vladak/radio2mqtt/README.md

# Radio (RFM69) to MQTT gateway

Receive messages in certain format over RFM69 based radio, decode them and publish as MQTT messages using Wi-Fi.
The code assumes ESP32 based Feather running CircuitPython and certain wiring of the Radio FeatherWing.

This is the receiver piece for [shield](https://github.com/vladak/shield/).

## Hardware

Here is a bill of materials:

Purpose | Name
---|---
microcontroller | [ESP32 Feather S3](https://www.adafruit.com/product/5477)
radio antenna | high power antenna 4dBi 433MHz (410~450 MHz) 20cm/90°foldable/SMA-J (ordered from eBay)
radio | [Radio FeatherWing 433 MHz](https://www.adafruit.com/product/3230) 
interconnect | [FeatherWing doubler](https://www.adafruit.com/product/2890)

Most of the stuff comes from [Adafruit](https://www.adafruit.com/).

## Physical packaging

Originally I used the ["tracking tag"](https://www.thingiverse.com/thing:2664919) enclosure that is originally designed for Feather M0 and GPS, however I needed something quick and this seems it would fit.

Then I remixed the QtPy case and created [custom enclosure](https://github.com/vladak/radio2mqtt/tree/main/Doubler%20snap%20fit%20case) (here showing a transmitter using the same case with battery and temperature/humidity sensor, the receiver does not generally have these):

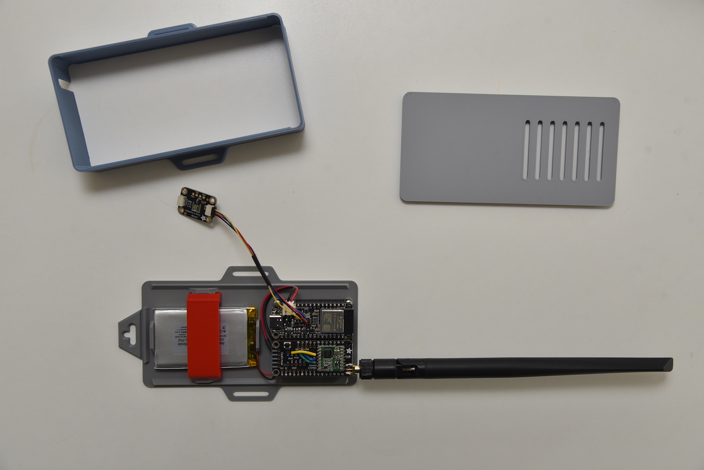
[picture p1: img/case-assembly-1.jpg]


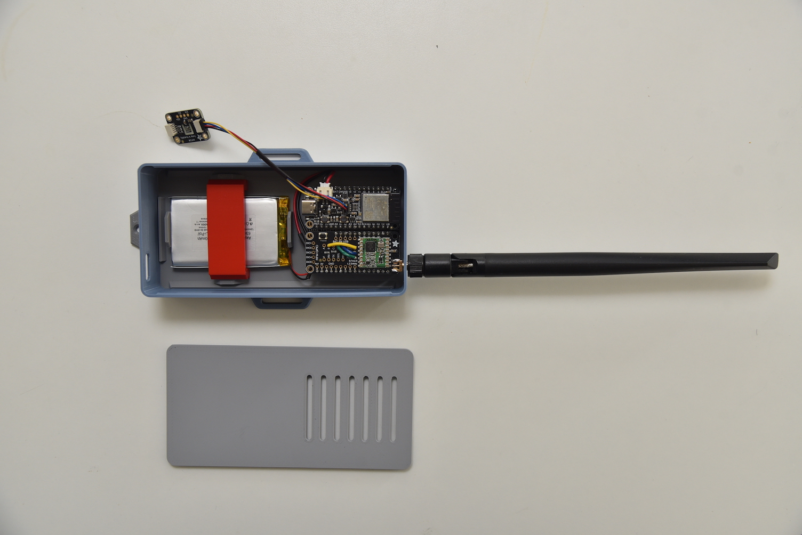
[picture p2: img/case-assembly-2.jpg]


## Software/firmware install

Firstly, the microcontroller needs to be converted to run CircuitPython 9.x (for the `circup` to work with web workflow). To do that, for ESP32 V2, I chose the [command line `esptool`](https://learn.adafruit.com/circuitpython-with-esp32-quick-start/command-line-esptool) on a Linux computer (since macOS appeared to have flaky serial connection for some reason), however these days it can be done using [Web Flasher](https://adafruit.github.io/Adafruit_WebSerial_ESPTool/) in Chrome.

If ESP32 V2 used, perform the initial set up by [creating the `settings.toml` file](https://learn.adafruit.com/circuitpython-with-esp32-quick-start/setting-up-web-workflow
) in the root directory (using `screen` when the board is connected via USB data cable) to enable web workflow:
```
f = open('settings.toml', 'w')
f.write('CIRCUITPY_WIFI_SSID = "MY_SSID"\n')
f.write('CIRCUITPY_WIFI_PASSWORD = "CHANGE_ME_WIFI_PASSWORD"\n')
f.write('CIRCUITPY_WEB_API_PASSWORD = "CHANGE_ME_WEB_API_PASSWORD"\n')
f.close()
```
and restart the microcontroller.

Then the following can be used:
- install the code
  - for ESP32S3 connected via USB, assumes Linux:
  ```
  cp *.py /media/$LOGNAME/CIRCUITPY/
  ``` 
  - for ESP32 V2, copy `*.py` files to the root directory using web workflow, assumes system with `curl` installed:
  ```
  for f in *.py; do curl -v -u :CHANGE_ME_WEB_API_PASSWORD -T "$f" -L --location-trusted "http://172.40.0.11/fs/$f"; done
  ```
- create `secrets.py` in the root directory (using the same technique as in the previous step)
- install necessary libraries from Adafruit CircuitPython bundle to the `lib` directory:
  - For Feather ESP32 V2, web based workflow has to be used:
  ```
  circup --host 172.40.0.11 --password CHANGE_ME_WEB_API_PASSWORD install -r requirements.txt
  ```
  - for ESP32-S2/ESP32-S3 and similar with USB mass storage access:
  ```
  circup install -r requirements.txt
  ```

## Configuration

There needs to be a `secrets.py` file that contains Wi-Fi credentials and MQTT configuration.
It can look like this:
```python
# This file is where you keep secret settings, passwords, and tokens!
# If you put them in the code you risk committing that info or sharing it

secrets = {
    "ssid": "foo",
    "password": "bar",
    "broker": "172.40.0.3",
    "broker_port": 1883,
    "allowed_topics": ["devices/terasa/shield"],
    "log_topic": "logs/terasa/radio2mqtt",
    "log_level": "INFO",
    "encryption_key": b"\x01\x02\x03\x04\x05\x06\x07\x08\x01\x02\x03\x04\x05\x06\x07\x08",
}
```

To transfer the file to the microcontroller, the same method as in the Install section should be used.

### Tunables

Purpose | Name                                                                                                                                              | Type | Kind
---|---------------------------------------------------------------------------------------------------------------------------------------------------|---|---
`ssid` | WiFi SSID                                                                                                                                         | `str` | Mandatory
`password` | WiFi password                                                                                                                                     | `str` | Mandatory
`broker` | MQTT broker address                                                                                                                               | `str` | Mandatory
`broker_port` | MQTT broker port                                                                                                                                  | `int` | Mandatory
`allowed_topics` | MQTT topics to publish messages to                                                                                                                 | `list` of `str` | Mandatory
`log_topic` | MQTT topic to publish log messages to                                                                                                             | `str` | Optional
`log_level` | log level, default `INFO`                                                                                                                         | `str` | Mandatory
`tx_power` | TX power to use for RFM69                                                                                                                          | `int` | Optional
`encryption_key` | 16 bytes of encryption key for RFM69                                                                                                               | `bytes` | Optional

## Lessons learned

- Using web workflow makes it easy for unattended upgrades or code changes
- The 433 MHz signal using 16.5 cm wire antenna can easily reach across the apartment, i.e. through brick/concrete walls and windows.
  - That said, it seems that the level of the placement matters. For example, when I put the sending side on the floor, the receiver (placed on top of a tall library, some 2 meters above the floor level) was not able to receive anything however when positioned a bit higher (1 meter above floor level), the receiver picked up the signal no problem. During this experiment, both antennas (16.5 straight wire) were horizontal.

## Guide/documentation links

Adafruit has largely such a good documentation that the links are worth putting here for quick reference:
- [web workflow RESTful API](https://docs.circuitpython.org/en/latest/docs/workflows.html#file-rest-api)
- [CircuitPython RGB Status Light color coding](https://learn.adafruit.com/welcome-to-circuitpython/troubleshooting#circuitpython-rgb-status-light-2978455)
- [CircuitPython for RFM69](https://learn.adafruit.com/radio-featherwing/circuitpython-for-rfm69)
- [on RFM69 wiring to the microcontroller pins](https://forums.adafruit.com/viewtopic.php?p=886292&hilit=433#p886292)
