vladak/radio2mqtt/img/case_closed.jpg

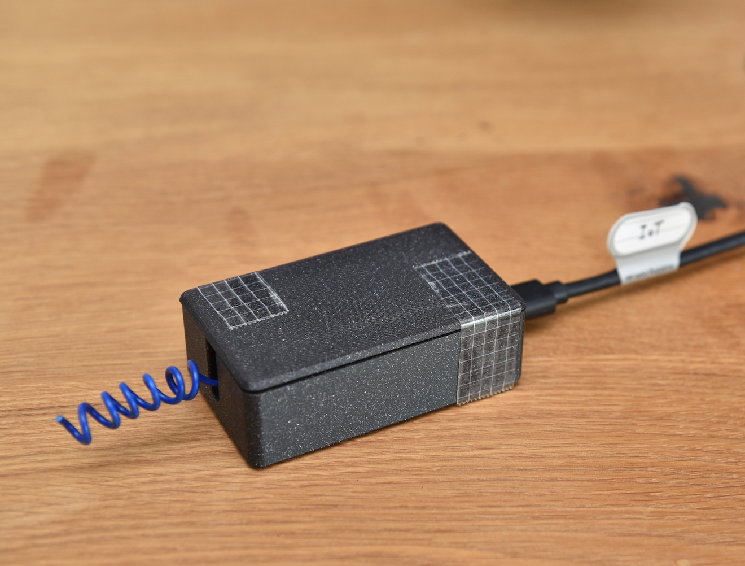
img/case_closed.jpg
