vladak/radio2mqtt/img/case_open.jpg

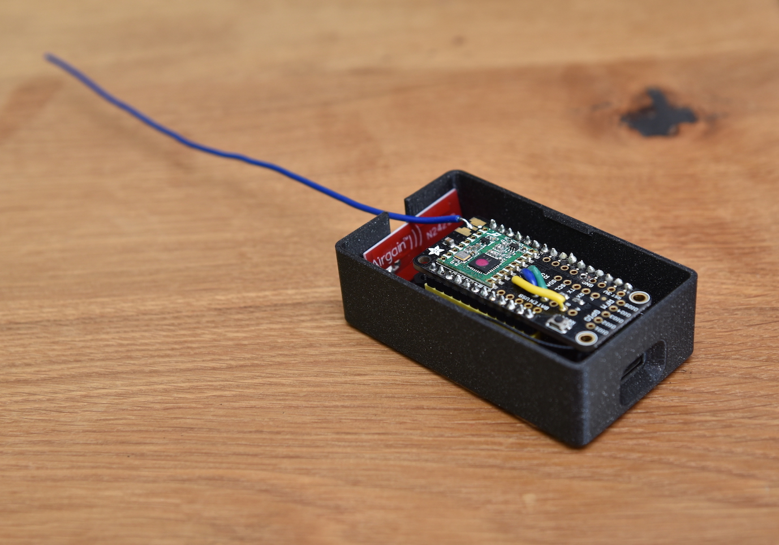
img/case_open.jpg
