vladak/radio2mqtt/Doubler snap fit case/doubler-battery_holder.stl

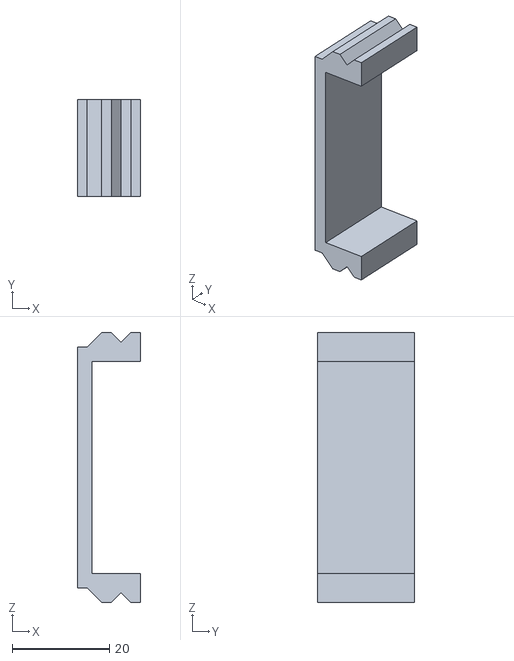
[picture p8: CAD file, 2026-03-19]
Doubler snap fit case/doubler-battery_holder.stl
13.0 x 20.0 x 55.5
