vladak/radio2mqtt/Doubler snap fit case/doubler-case.stl

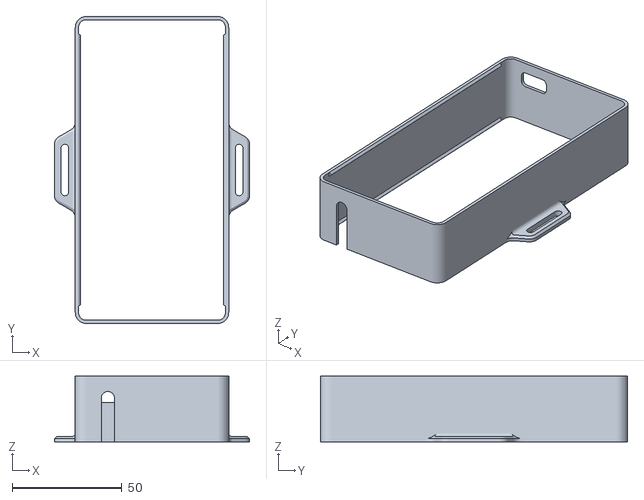
[picture p9: CAD file, 2026-03-19]
Doubler snap fit case/doubler-case.stl
89.0 x 140.0 x 30.0
