vladak/radio2mqtt/Doubler snap fit case/doubler-case-top.stl

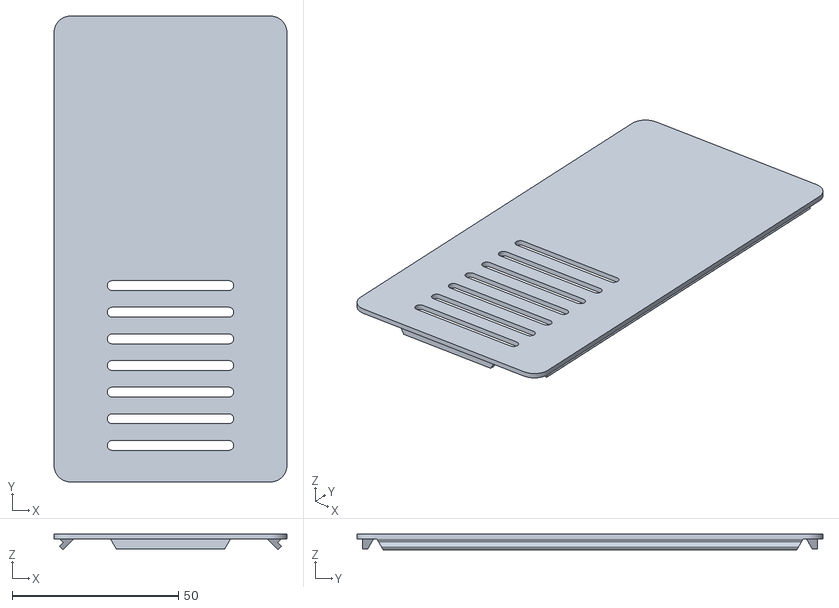
[picture p10: CAD file, 2026-03-19]
Doubler snap fit case/doubler-case-top.stl
70.0 x 140.0 x 4.70
