vladak/radio2mqtt/Doubler snap fit case/doubler-case-bottom.stl

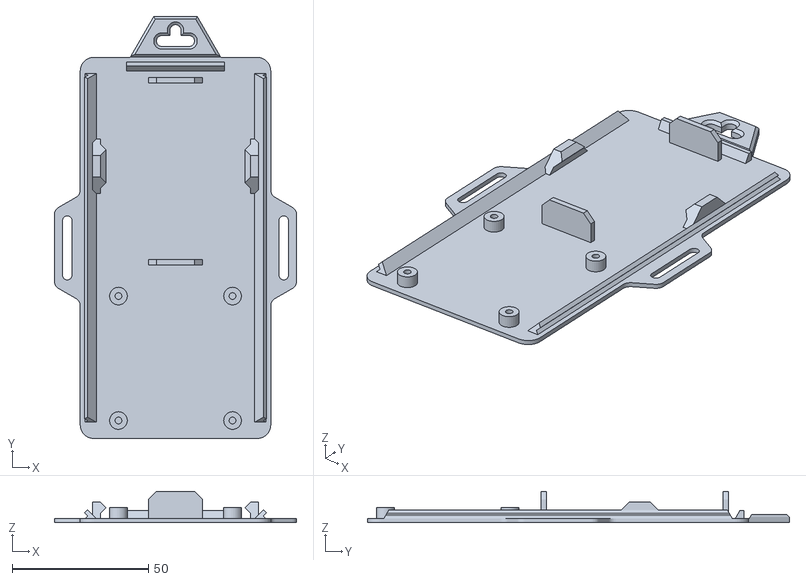
[picture p11: CAD file, 2026-03-19]
Doubler snap fit case/doubler-case-bottom.stl
89.0 x 155.0 x 11.5
