vladak/radio2mqtt/(list of files, cad)

Other CAD files:
Doubler snap fit case/Doubler snap fit case.f3d
