vladak/radio2mqtt/(threads)

Thread 5 (2024-05-17):

add photos to README.md

vladak, 2024-05-17:
Once the enclosure is 3D printed and the Neopixel fitted inside, take a picture and add it to the README.md.

vladak, 2024-05-19:
Also, label the USB cable.

Closed 2024-05-23.

Thread 8 (2024-11-01):

figure out the enclosure

vladak, 2024-11-01:
With the Feather, Ethernet wing, RFM69 wing and the doubler/tripler board, this makes it pretty unique combination. Custom enclosure would have to be designed, e.g. use https://www.youtube.com/watch?v=KwK3TnOSWus and try to remix https://learn.adafruit.com/qt-py-snap-fit-case

Thread 9 (2025-03-07):

use watchdog

vladak, 2025-03-07:
Use watchdog for better operation. I noticed a gap in the measurements that could be caused by the microcontroller being stuck for couple of hours because in the MQTT log topic it looked like this:
```
...
Client (null) received PINGRESP
Client (null) sending PINGREQ
Client (null) received PINGRESP
Client (null) sending PINGREQ
Client (null) received PINGRESP
Client (null) sending PINGREQ
Client (null) received PINGRESP
Client (null) sending PINGREQ
Client (null) received PINGRESP
Client (null) sending PINGREQ
Client (null) received PINGRESP
Client (null) sending PINGREQ
Client (null) received PINGRESP
Client (null) received PUBLISH (d0, q0, r0, m0, 'devices/logs/radio2mqtt', ... (18 bytes))
2025-03-07T07:12:04+0100 devices/logs/radio2mqtt: Temperature: 35.0C
Client (null) received PUBLISH (d0, q0, r0, m0, 'devices/logs/radio2mqtt', ... (19 bytes))
2025-03-07T07:12:04+0100 devices/logs/radio2mqtt: Frequency: 433.0mhz
Client (null) received PUBLISH (d0, q0, r0, m0, 'devices/logs/radio2mqtt', ... (21 bytes))
2025-03-07T07:12:04+0100 devices/logs/radio2mqtt: Bit rate: 250.0kbit/s
Client (null) received PUBLISH (d0, q0, r0, m0, 'devices/logs/radio2mqtt', ... (31 bytes))
2025-03-07T07:12:04+0100 devices/logs/radio2mqtt: Frequency deviation: 250000.0hz
Client (null) received PUBLISH (d0, q0, r0, m0, 'devices/logs/radio2mqtt', ... (22 bytes))
2025-03-07T07:12:04+0100 devices/logs/radio2mqtt: Waiting for packets...
Client (null) received PUBLISH (d0, q0, r0, m0, 'devices/logs/radio2mqtt', ... (133 bytes))
2025-03-07T07:12:20+0100 devices/logs/radio2mqtt: Publishing to devices/terasa/shield: {"lux": 0.0, "co2_ppm": 0, "battery_level": 93.7031, "temperature": 2.4375, "humidity": 86.9484}
```
So it looks like the device got restarted in the end for some reason.
