vladak/radio2mqtt/code.py

"""
Receive packets over radio using RFM69 and if they fit certain form,
replay their content to a MQTT topic to specified MQTT broker.

Assumes Adafruit Feather ESP32 V2 and certain wiring of 433 MHz Radio FeatherWing.
"""

import json
import math
import struct
import time
import traceback

import adafruit_logging as logging
import adafruit_rfm69
import board
import busio
import digitalio
import microcontroller
import neopixel

# pylint: disable=import-error
import socketpool

# pylint: disable=import-error
import supervisor
import wifi

# pylint: disable=no-name-in-module
from microcontroller import watchdog
from watchdog import WatchDogMode, WatchDogTimeout

from binarystate import BinaryState
from confchecks import check_bytes, check_int, check_list, check_string
from hexdump import Hexdump
from logutil import get_log_level
from mqtt import mqtt_client_setup
from mqtt_handler import MQTTHandler

try:
    from secrets import secrets
except ImportError:
    print(
        "WiFi credentials and configuration are kept in secrets.py, please add them there!"
    )
    raise


BROKER_PORT = "broker_port"
LOG_TOPIC = "log_topic"
BROKER = "broker"
PASSWORD = "password"
SSID = "ssid"
LOG_LEVEL = "log_level"
ENCRYPTION_KEY = "encryption_key"
ALLOWED_TOPICS = "allowed_topics"


class PacketDecodingError(Exception):
    """
    Exception raised when a packet cannot be decoded.
    """


def blink(pixel):
    """
    Blink the Neo pixel blue.
    """
    pixel.brightness = 0.3
    pixel.fill((0, 0, 255))
    time.sleep(0.5)
    pixel.brightness = 0


def check_tunables():
    """
    Check that tunables are present and of correct type.
    Will exit the program on error.
    """
    check_string(LOG_LEVEL)

    # Even though different transport can be selected than WiFi, the related tunables
    # are still mandatory, because at this point it is known which will be selected.
    # Also, MQTT topic is used for all transports.
    check_string(SSID)
    check_string(PASSWORD)
    check_string(BROKER)
    check_string(LOG_TOPIC, mandatory=False)
    check_int(BROKER_PORT, min_val=0, max_val=65535)

    check_list(ALLOWED_TOPICS, str)

    check_bytes(ENCRYPTION_KEY, 16, mandatory=False)


# pylint: disable=too-many-locals,too-many-statements
def main():
    """
    main loop: collect messages via radio, decode and publish to MQTT
    """

    check_tunables()

    log_level = get_log_level(secrets[LOG_LEVEL])
    logger = logging.getLogger("")
    logger.setLevel(log_level)

    # The initialization code below should not take long and the endless loop is quite tight,
    # so 5 seconds should be more than enough.
    watchdog.timeout = 5
    watchdog.mode = WatchDogMode.RAISE

    logger.info("Running")

    # Assumes certain wiring of the Radio FeatherWing.
    cs = digitalio.DigitalInOut(board.D5)
    reset = digitalio.DigitalInOut(board.D6)

    spi = busio.SPI(board.SCK, MOSI=board.MOSI, MISO=board.MISO)

    rfm69 = adafruit_rfm69.RFM69(spi, cs, reset, 433)  # Europe

    encryption_key = secrets.get(ENCRYPTION_KEY)
    if encryption_key:
        logger.debug("Setting encryption key")
        rfm69.encryption_key = encryption_key

    mqtt_client = get_mqtt_client()

    logger.debug(f"allowed topics: {secrets.get(ALLOWED_TOPICS)}")

    logger.info(f"Temperature: {rfm69.temperature}C")
    logger.info(f"Frequency: {rfm69.frequency_mhz}mhz")
    logger.info(f"Bit rate: {rfm69.bitrate / 1000}kbit/s")
    logger.info(f"Frequency deviation: {rfm69.frequency_deviation}hz")

    # The Neopixel will blink only then logging level is set to DEBUG however initialize it anyway.
    pixel = neopixel.NeoPixel(board.NEOPIXEL, 1)
    pixel.brightness = 0
    pixel_state = BinaryState()
    pixel_state.update("off")

    # Assumes tight loop below. The value is approximate. If there is high frequency of packets
    # (i.e. more frequent than this delay), the blinking will degrade into solid light.
    pixel_blink_delay = 300  # in milliseconds

    # Wait to receive packets.  Note that this library can't receive data at a fast
    # rate, in fact it can only receive and process one 60 byte packet at a time.
    # This means you should only use this for low bandwidth scenarios, like sending
    # and receiving a single message at a time.
    logger.info("Waiting for packets...")
    while True:
        watchdog.feed()

        mqtt_client.loop(0.1)

        packet = rfm69.receive(timeout=0.1)
        if packet is None:
            if logger.getEffectiveLevel() == logging.DEBUG:  # pylint: disable=no-member
                if pixel_state.cur_state == "on":
                    # Finish the blink if the Neopixel is on.
                    on_ms = pixel_state.update("on")
                    logger.debug(f"neopixel has been on for {on_ms} ms")
                    if on_ms > pixel_blink_delay:
                        logger.debug("turning the neopixel off")
                        pixel.brightness = 0
                        pixel_state.update("off")

            continue

        # See the strength of the radio signal being received.
        # This is updated when packets are received and returns a value in decibels
        # (typically negative, so the smaller the number and closer to 0,
        # the higher the strength / better the signal).
        logger.debug(f"RSSI: {rfm69.last_rssi}")

        logger.debug(f"Received packet of {len(packet)} bytes:\n{Hexdump(packet)}")

        if logger.getEffectiveLevel() == logging.DEBUG:  # pylint: disable=no-member
            on_ms = pixel_state.update("on")
            logger.debug(f"neopixel has been on for {on_ms} ms")
            if on_ms < pixel_blink_delay:
                logger.debug("turning the neopixel on")
                pixel.brightness = 1
                pixel.fill((0, 0, 255))
            else:
                logger.debug("turning the neopixel off")
                pixel.brightness = 0
                pixel_state.update("off")

        try:
            mqtt_topic, pub_data_dict = decode_packet(packet)
        except PacketDecodingError as packet_exc:
            logger.warning(str(packet_exc))
            continue
        try:
            pub_data = json.dumps(pub_data_dict)
        except TypeError:
            logger.warning(f"failed to convert to JSON: {pub_data_dict}")
            continue

        logger.info(f"Publishing to {mqtt_topic}: {pub_data}")
        mqtt_client.publish(mqtt_topic, pub_data)


def decode_packet(packet):
    """
    Decode packet, return MQTT topic and dictionary of items.
    Raises PacketDecodingError on error.
    """
    logger = logging.getLogger("")

    mqtt_prefix = "MQTT:"
    max_mqtt_topic_len = 32
    fmt = f">{len(mqtt_prefix)}s{max_mqtt_topic_len}sffIff"
    if struct.calcsize(fmt) > 60:
        logger.warning("the format for structure packing is bigger than 60 bytes")
    try:
        data = struct.unpack(fmt, packet)
    except RuntimeError as e:
        raise PacketDecodingError("failed to unpack data") from e
    if len(data) != 7:
        raise PacketDecodingError(f"invalid data: {data}")
    try:
        prefix = data[0].decode("ascii")
    except UnicodeError as unicode_exc:
        raise PacketDecodingError(f"failed to decode data: {data}") from unicode_exc
    if prefix != mqtt_prefix:
        raise PacketDecodingError(f"not a MQTT prefix: {prefix}")

    mqtt_topic = data[1].decode("ascii")
    nul_idx = mqtt_topic.find("\x00")
    if nul_idx > 0:
        mqtt_topic = mqtt_topic[:nul_idx]
    logger.debug(f"MQTT topic: {mqtt_topic}")
    if mqtt_topic not in secrets.get(ALLOWED_TOPICS):
        raise PacketDecodingError(f"not allowed topic: '{mqtt_topic}'")

    data = data[2:]

    pub_data_dict = {}
    if not math.isnan(data[0]):
        pub_data_dict["humidity"] = data[0]
    if not math.isnan(data[1]):
        pub_data_dict["temperature"] = data[1]
    if data[2] != 0:
        pub_data_dict["co2_ppm"] = data[2]
    if not math.isnan(data[3]):
        pub_data_dict["battery_level"] = data[3]
    if not math.isnan(data[4]):
        pub_data_dict["lux"] = data[4]

    return mqtt_topic, pub_data_dict


def get_mqtt_client():
    """
    Connect to Wi-Fi and initialize MQTT client
    """
    logger = logging.getLogger("")

    logger.info("Connecting to wifi")
    wifi.radio.connect(secrets[SSID], secrets[PASSWORD], timeout=10)
    logger.info(f"Connected to {secrets['ssid']}")
    logger.debug(f"IP: {wifi.radio.ipv4_address}")

    pool = socketpool.SocketPool(wifi.radio)  # pylint: disable=no-member

    broker_addr = secrets[BROKER]
    broker_port = secrets[BROKER_PORT]
    mqtt_client = mqtt_client_setup(
        pool, broker_addr, broker_port, logger.getEffectiveLevel(), socket_timeout=0.1
    )

    try:
        log_topic = secrets[LOG_TOPIC]
        # Log both to the console and via MQTT messages.
        # Up to now the logger was using the default (built-in) handler,
        # now it is necessary to add the Stream handler explicitly as
        # with a non-default handler set only the non-default handlers will be used.
        logger.addHandler(logging.StreamHandler())
        logger.addHandler(MQTTHandler(mqtt_client, log_topic))
    except KeyError:
        pass

    logger.info(f"Attempting to connect to MQTT broker {broker_addr}:{broker_port}")
    mqtt_client.connect()

    return mqtt_client


def hard_reset(exception):
    """
    Sometimes soft reset is not enough. Perform hard reset.
    """
    watchdog.mode = None
    print(f"Got exception: {exception}")
    reset_time = 15
    print(f"Performing hard reset in {reset_time} seconds")
    time.sleep(reset_time)
    microcontroller.reset()  # pylint: disable=no-member


try:
    main()
except ConnectionError as e:
    # When this happens, it usually means that the microcontroller's wifi/networking is botched.
    # The only way to recover is to perform hard reset.
    hard_reset(e)
except MemoryError as e:
    # This is usually the case of delayed exception from the 'import wifi' statement,
    # possibly caused by a bug (resource leak) in CircuitPython that manifests
    # after a sequence of ConnectionError exceptions thrown from withing the wifi module.
    # Should not happen given the above 'except ConnectionError',
    # however adding that here just in case.
    hard_reset(e)
except Exception as e:  # pylint: disable=broad-except
    # This assumes that such exceptions are quite rare.
    # Otherwise, this would drain the battery quickly by restarting
    # over and over in a quick succession.
    watchdog.mode = None
    print("Code stopped by unhandled exception:")
    print(traceback.format_exception(None, e, e.__traceback__))
    RELOAD_TIME = 10
    print(f"Performing a supervisor reload in {RELOAD_TIME} seconds")
    time.sleep(RELOAD_TIME)
    supervisor.reload()
except WatchDogTimeout as e:
    hard_reset(e)
