vladak/radio2mqtt/(commit log)

2024-05-16 initial change
    [.isort.cfg]
2024-05-16 move TODOs to issues
    [code.py]
2024-05-17 add type of antenna
2024-05-17 mention the case
2024-05-17 remove mention of ESP32-S2
2024-05-19 blink the neopixel on each received packet
    fixes #4
    [binarystate.py, code.py]
2024-05-20 hexdump the packet in debug mode
    fixes #2
    [code.py, hexdump.py]
2024-05-24 loosen the pylint disable
    [code.py]
2024-07-19 on antenna position
2025-01-30 use ESP32-S3
2025-03-07 use watchdog
    fixes #9
    [code.py]
2026-02-26 Remove enclosure link from README
    Removed the link to the enclosure files from Thingiverse.
2026-02-26 Add radio antenna information to README
2026-02-26 Update README with installation instructions for libraries
    Clarify installation instructions for Adafruit libraries based on device type.
2026-02-26 Update README to specify CircuitPython usage
    Clarify that the code runs on CircuitPython.
2026-02-26 Update README with ESP32 V2 setup instructions
    Clarified setup instructions for ESP32 V2 and added details for file copying methods.
2026-02-26 Update README with ESP32 V2 setup instructions
    Clarified instructions for setting up ESP32 V2 with CircuitPython.
2026-03-19 add the case
    fixes #8
    [Doubler snap fit case.f3d, doubler-battery_holder.stl, doubler-case-bottom.stl, doubler-case-top.stl, doubler-case.stl]
2026-03-19 add images of failed prints
2026-03-19 add new case images
2026-03-19 Update README with custom enclosure link
2026-03-19 Update printing details in README.md
